Dewcly/CPU-design-based-on-MIPS-instructions/README.md

logisim开发，基于MIPS指令集的CPU设计;
包括单周期CPU，经典五段流水CPU;
hex文件为测试文件；
单周期上板是基于FPGA开发板设计CPU。
