Dewcly/CPU-design-based-on-MIPS-instructions/(list of files, drawings)

Other design files:
alu.circ
cpu_单级中断.circ
cpu_多级中断.circ
cpu_气泡.circ
cpu_流水中断.circ
cpu_理想 .circ
cpu_重定向.circ
